gx1400/KiCad_PowerSupply_RegulatorAndControl/Regulator.kicad_pcb

## KiCad design Regulator.kicad_pcb (2017-05-18)

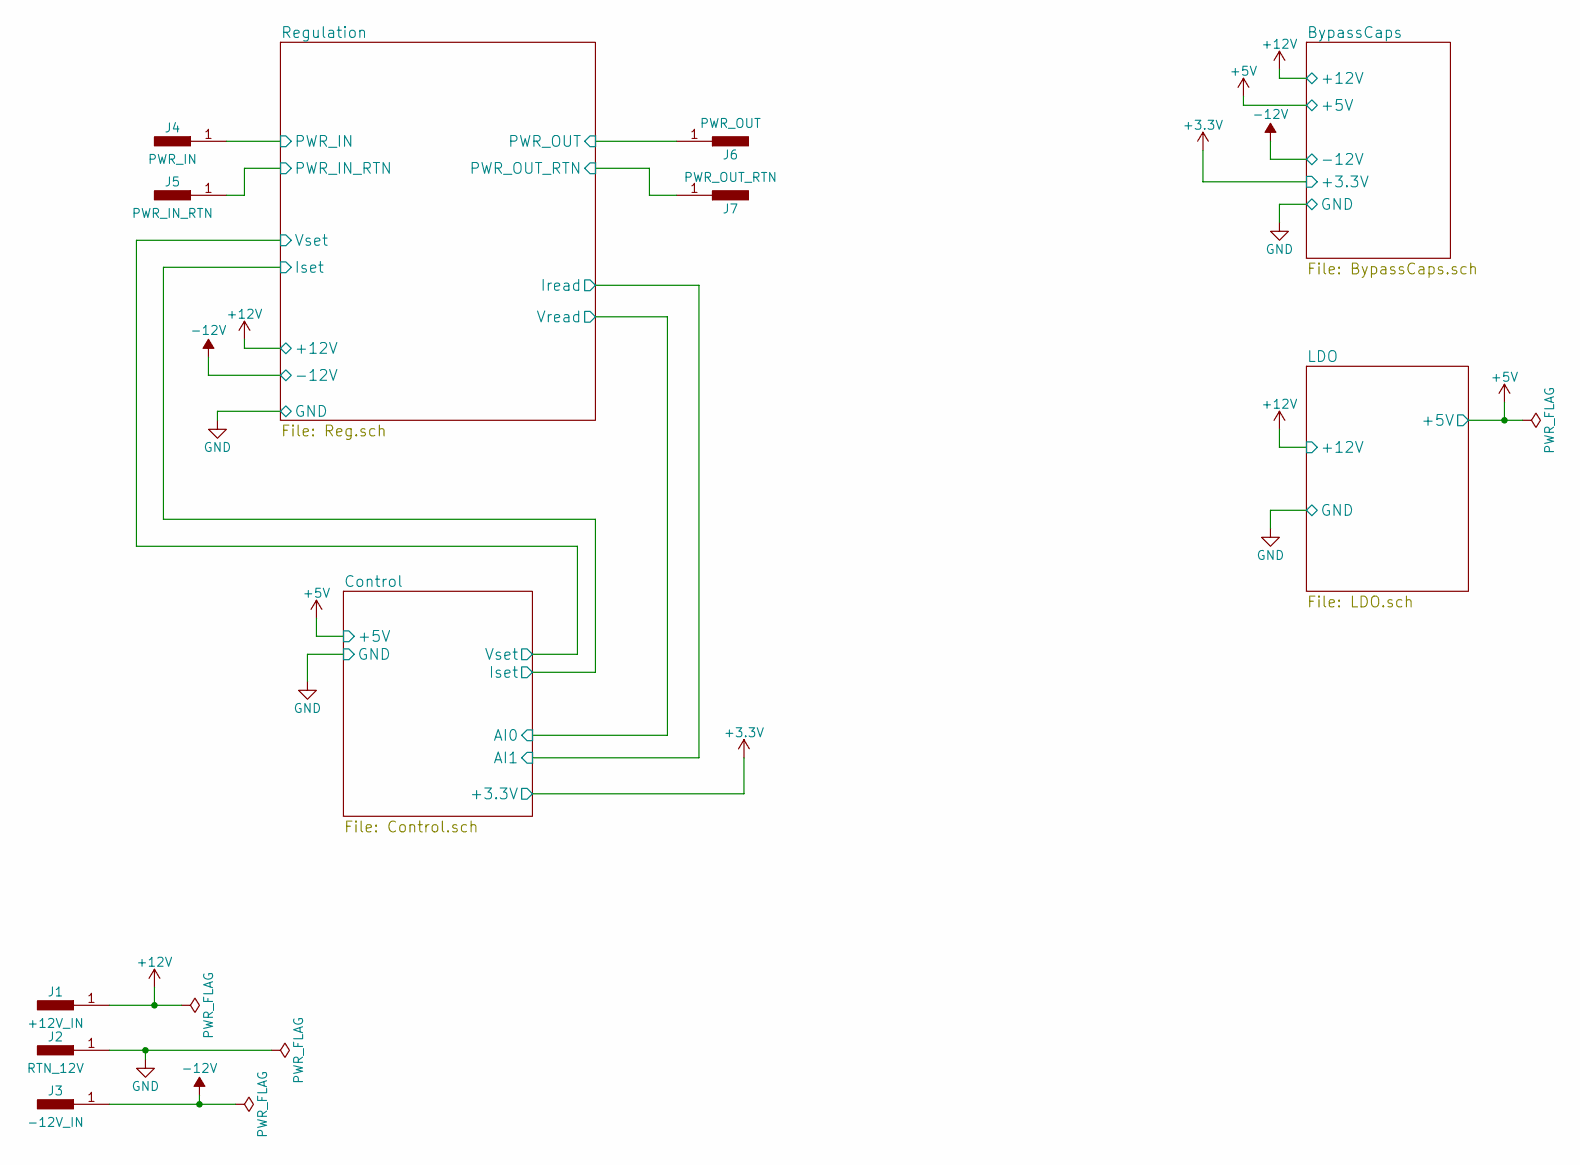
[picture p1: schematic Regulator.sch]

Parts:
J1: +12V_IN; SolderWirePad_2x_1-5mmDrill; MPN 1217861-1
J2: RTN_12V; SolderWirePad_2x_1-5mmDrill; MPN 1217861-1
J3: -12V_IN; SolderWirePad_2x_1-5mmDrill; MPN 1217861-1
J4: PWR_IN; SolderWirePad_2x_1-5mmDrill; MPN 1217861-1
J5: PWR_IN_RTN; SolderWirePad_2x_1-5mmDrill; MPN 1217861-1
J6: PWR_OUT; SolderWirePad_2x_1-5mmDrill; MPN 1217861-1
J7: PWR_OUT_RTN; SolderWirePad_2x_1-5mmDrill; MPN 1217861-1

Connections:
+12V: J1.1; also elsewhere on the board
-12V: J3.1; also elsewhere on the board
/Regulation/PWR_IN: J4.1; also elsewhere on the board
/Regulation/PWR_OUT: J6.1; also elsewhere on the board
GND: J2.1, J5.1, J7.1; also elsewhere on the board

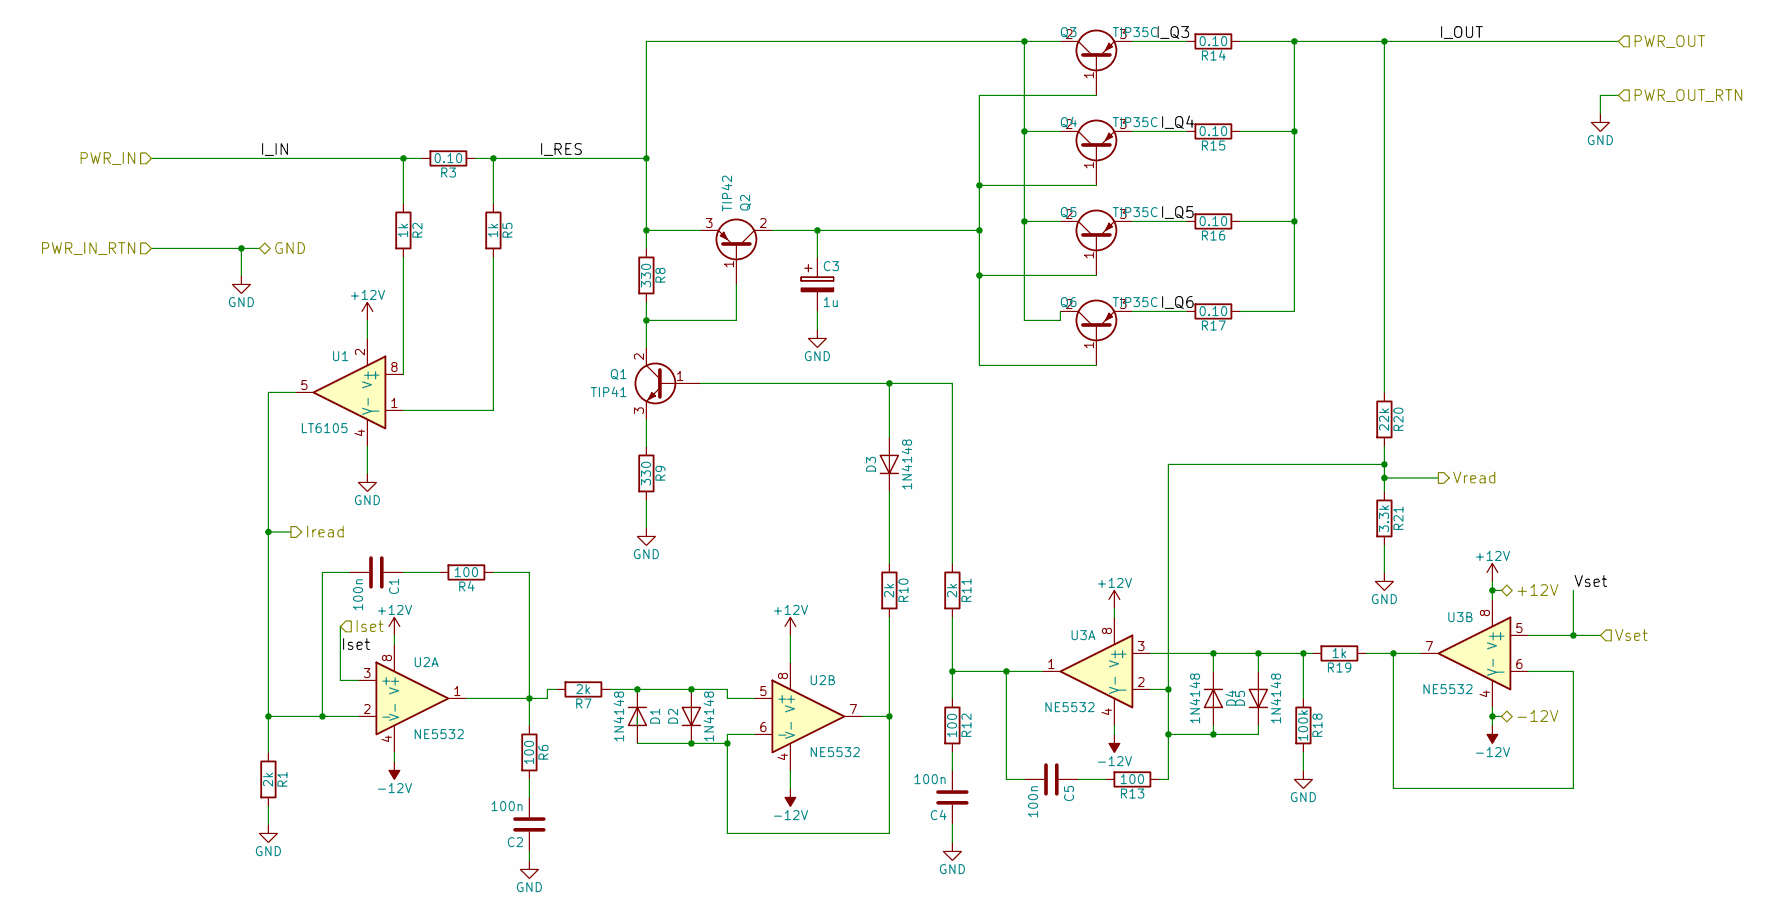
[picture p2: schematic Reg.sch]

Parts:
C1, C2, C4, C5: 100n; C_0805_HandSoldering; MPN CL21B104JBCNNNC
C3: 1u; CP_Radial_D4.0mm_P1.50mm; MPN CL21B105KBFNNNG
D1, D2, D3, D4, D5: 1N4148; D_SOD-123; MPN 1N4148W-TP
Q1: TIP41; TO-220_Vertical; MPN TIP41C
Q2: TIP42; TO-220_Vertical; MPN TIP42CTU
Q3, Q4, Q5, Q6: TIP35C; TO-247_TO-3P_Vertical; MPN TIP35CW
R1, R7, R10, R11: 2k; R_0805_HandSoldering; MPN ERJ-6ENF2001V
R2, R5, R19: 1k; R_0805_HandSoldering; MPN ERJ-6GEYJ102V
R3: 0.10; RESISTOR_SMD_BOURNES_DPAK; MPN PWR163S-25-R100F
R4, R6, R12, R13: 100; R_0805_HandSoldering; MPN ERJ-P06J101V
R8, R9: 330; R_0805_HandSoldering; MPN ERJ-6GEYJ331V
R14, R15, R16, R17: 0.10; R_2512_HandSoldering; MPN PE2512FKE070R1L
R18: 100k; R_0805_HandSoldering; MPN ERJ-6ENF1003V
R20: 22k; R_0805_HandSoldering; MPN ERJ-6ENF2202V
R21: 3.3k; R_0805_HandSoldering; MPN ERJ-6ENF3301V
U1: LT6105; MSOP-8_3x3mm_Pitch0.65mm; MPN LT6105CMS8#PBF
U2, U3: NE5532; SOIC-8_3.9x4.9mm_Pitch1.27mm; MPN NE5532DR

Connections:
+12V: U1.2 (V+), U2.8 (V+), U3.8 (V+); also elsewhere on the board
-12V: U2.4 (V-), U3.4 (V-); also elsewhere on the board
/Control/AI0: D4.2 (A), D5.1 (K), R13.1, R20.2, R21.1, U3.2 (-); also elsewhere on the board
/Control/AI1: C1.2, R1.1, U1.5, U2.2 (-); also elsewhere on the board
/Control/Iset: U2.3 (+); also elsewhere on the board
/Control/Vset: U3.5 (+); also elsewhere on the board
/Regulation/I_Q3: Q3.3 (E), R14.2
/Regulation/I_Q4: Q4.3 (E), R15.2
/Regulation/I_Q5: Q5.3 (E), R16.2
/Regulation/I_Q6: Q6.3 (E), R17.2
/Regulation/I_RES: Q2.3 (E), Q3.2 (C), Q4.2 (C), Q5.2 (C), Q6.2 (C), R3.1, R5.1, R8.1
/Regulation/PWR_IN: R2.1, R3.2; also elsewhere on the board
/Regulation/PWR_OUT: R14.1, R15.1, R16.1, R17.1, R20.1; also elsewhere on the board
GND: C2.1, C3.2, C4.1, R1.2, R9.2, R18.2, R21.2, U1.4 (V-); also elsewhere on the board
unnamed: C1.1, R4.2
unnamed: C2.2, R6.2
unnamed: C3.1, Q2.2 (C), Q3.1 (B), Q4.1 (B), Q5.1 (B), Q6.1 (B)
unnamed: C4.2, R12.2
unnamed: C5.1, R13.2
unnamed: C5.2, R11.2, R12.1, U3.1
unnamed: D1.1 (K), D2.2 (A), R7.1, U2.5 (+)
unnamed: D1.2 (A), D2.1 (K), R10.2, U2.6 (-), U2.7
unnamed: D3.1 (K), R10.1
unnamed: D3.2 (A), Q1.1 (B), R11.1
unnamed: D4.1 (K), D5.2 (A), R18.1, R19.2, U3.3 (+)
unnamed: Q1.2 (C), Q2.1 (B), R8.2
unnamed: Q1.3 (E), R9.1
unnamed: R2.2, U1.8 (+)
unnamed: R4.1, R6.1, R7.2, U2.1
unnamed: R5.2, U1.1 (-)
unnamed: R19.1, U3.6 (-), U3.7

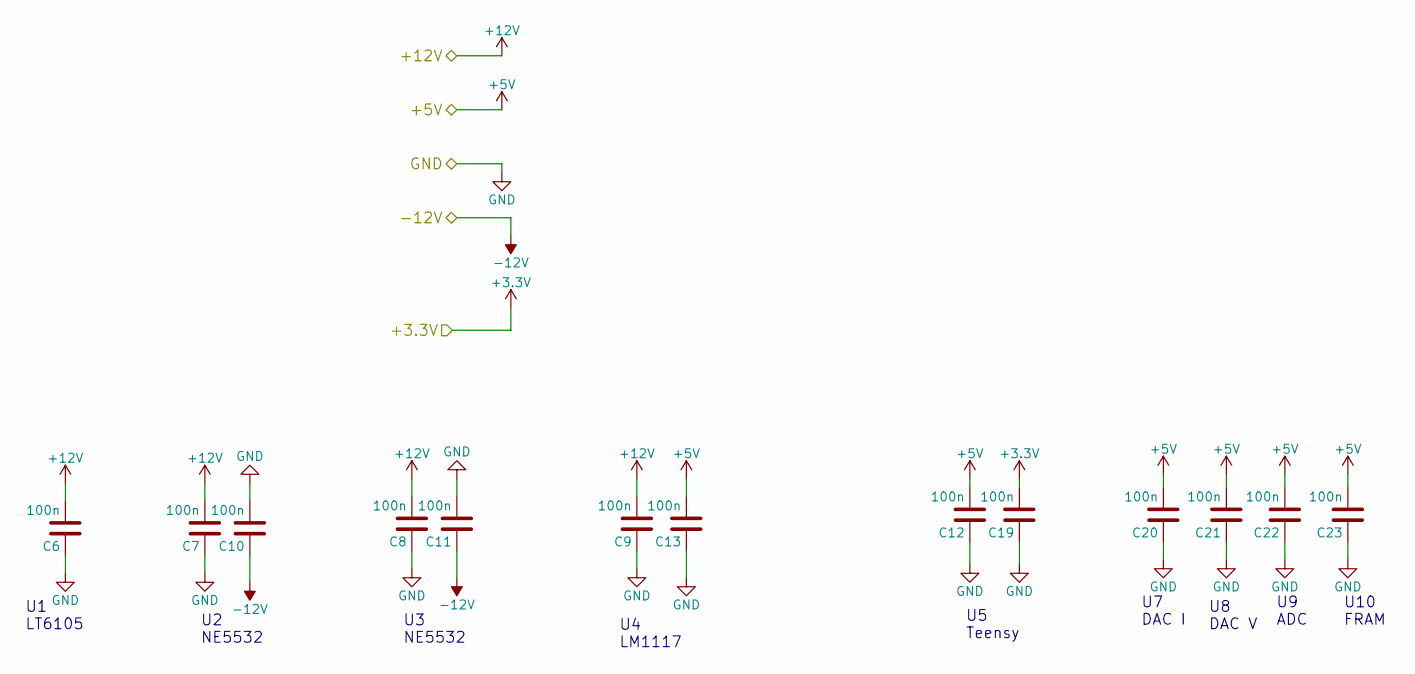
[picture p3: schematic BypassCaps.sch]

Parts:
C6, C7, C8, C9, C10, C11, C12, C13, C19, C20, C21, C22, C23: 100n; C_0805_HandSoldering; MPN CL21B104JBCNNNC

Connections:
+3V3: C19.2; also elsewhere on the board
+5V: C12.2, C13.2, C20.2, C21.2, C22.2, C23.2; also elsewhere on the board
+12V: C6.2, C7.2, C8.2, C9.2; also elsewhere on the board
-12V: C10.1, C11.1; also elsewhere on the board
GND: C6.1, C7.1, C8.1, C9.1, C10.2, C11.2, C12.1, C13.1, C19.1, C20.1, C21.1, C22.1, C23.1; also elsewhere on the board

Notes on the sheet:
U1 LT6105
U2 NE5532
U3 NE5532
U4 LM1117
U5 Teensy
U7 DAC I
U8 DAC V
U9 ADC
U10 FRAM

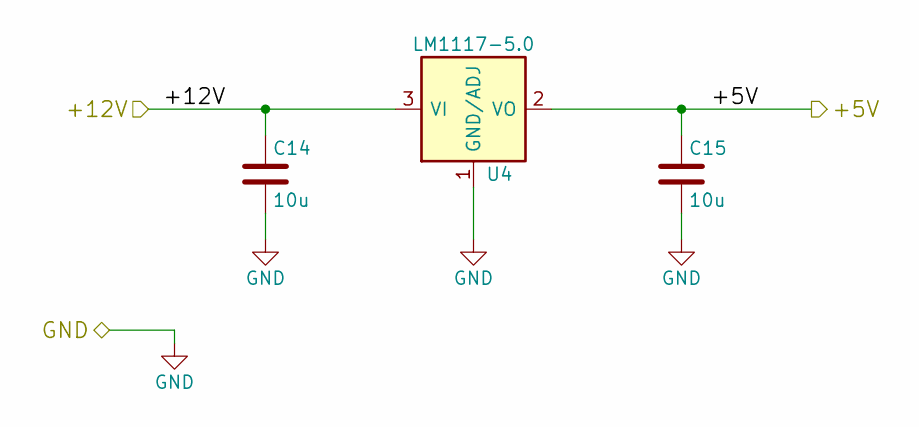
[picture p4: schematic LDO.sch]

Parts:
C14, C15: 10u; C_0805_HandSoldering; MPN F951C106MPAAQ2
U4: LM1117-5.0; SOT-223; MPN LM1117MP-5.0/NOPB

Connections:
+5V: C15.1, U4.2 (VO), U4.4 (VO); also elsewhere on the board
+12V: C14.1, U4.3 (VI); also elsewhere on the board
GND: C14.2, C15.2, U4.1 (GND/ADJ); also elsewhere on the board

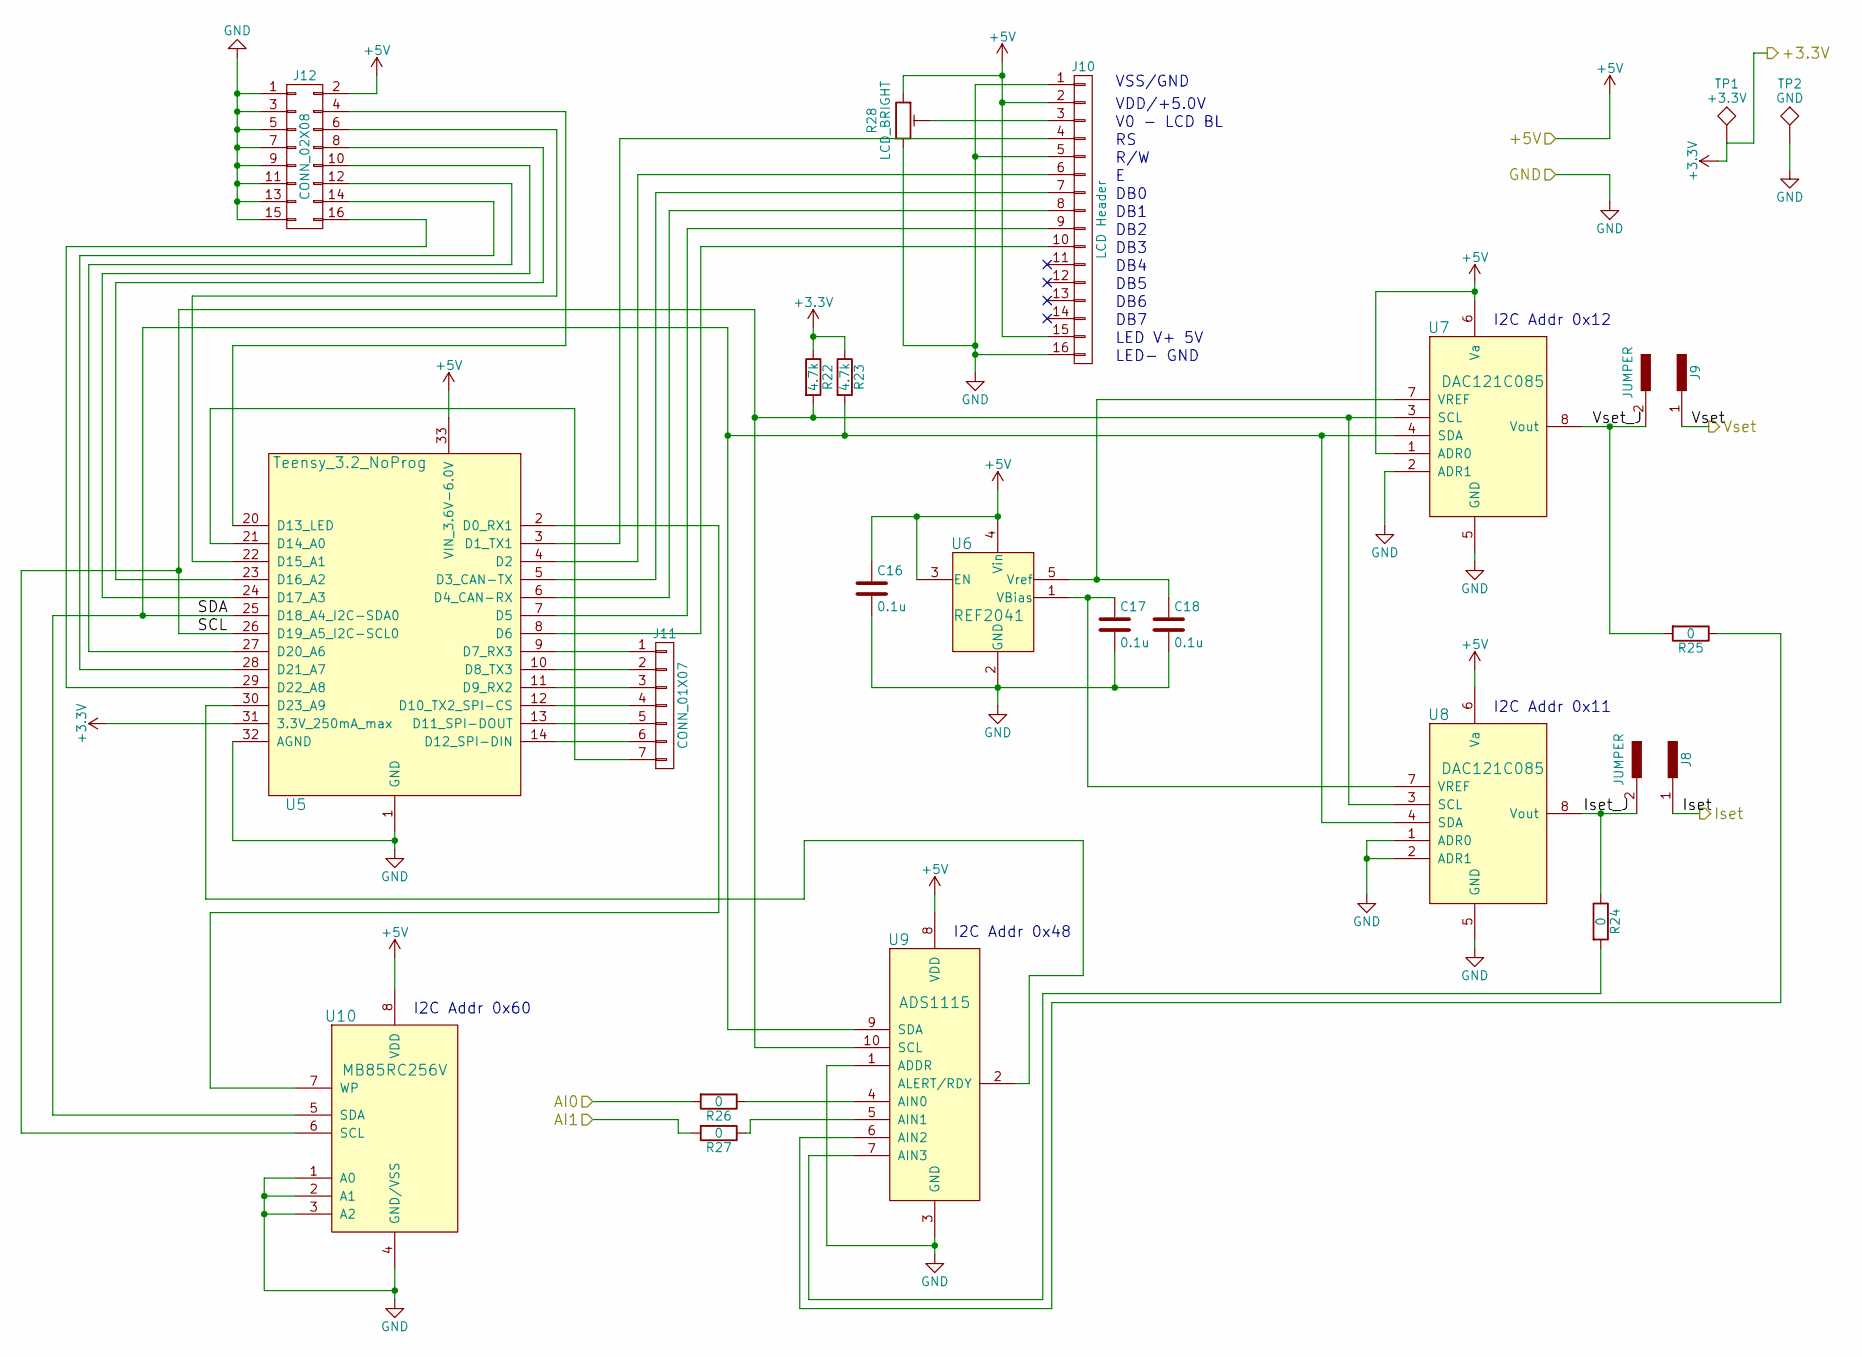
[picture p5: schematic Control.sch]

Parts:
C16, C17, C18: 0.1u; C_0805_HandSoldering; MPN C0805C104K4RACTU
J8, J9: JUMPER; R_0805_HandSoldering
J10: LCD Header; Pin_Header_Straight_1x16_Pitch2.54mm
J11: CONN_01X07; Pin_Header_Straight_1x07_Pitch2.54mm
J12: CONN_02X08; IDC_Header_Straight_16pins
R22, R23: 4.7k; R_0805_HandSoldering; MPN ERJ-6GEYJ472V
R24, R25, R26, R27: 0; R_0805_HandSoldering; MPN ERJ-6GEY0R00V
R28: LCD_BRIGHT; Potentiometer_Trimmer_Bourns_3266Y; MPN 3266Y-1-503LF
TP1: +3.3V; Test_Point_Keystone_5000-5004_Miniature; MPN 5000
TP2: GND; Test_Point_Keystone_5000-5004_Miniature; MPN 5001
U5: Teensy_3.2_NoProg; CUSTOM_Teensy_3.2_NoProg; MPN Teensy3.2
U6: REF2041; SOT-23-5_HandSoldering
U7, U8: DAC121C085; MSOP-8_3x3mm_Pitch0.65mm; MPN DAC121C085CIMM/NOPB
U9: ADS1115; MSOP-10_3x3mm_Pitch0.5mm; MPN ADS1115IDGST
U10: MB85RC256V; SOIJ-8_5.3x5.3mm_Pitch1.27mm; MPN MB85RC256VPF-G-JNERE2

Connections:
+3V3: R22.1, R23.1, TP1.1, U5.31 (3.3V_250mA_max); also elsewhere on the board
+5V: C16.1, J10.2, J10.15, J12.2, R28.1, U5.33 (VIN_3.6V-6.0V), U6.3 (EN), U6.4 (Vin), U7.1 (ADR0), U7.6 (Va), U8.6 (Va), U9.8 (VDD), U10.8 (VDD); also elsewhere on the board
/Control/AI0: R26.2; also elsewhere on the board
/Control/AI1: R27.2; also elsewhere on the board
/Control/Iset: J8.1; also elsewhere on the board
/Control/Iset_J: J8.2, R24.1, U8.8 (Vout)
/Control/SCL: R22.2, U5.26 (D19_A5_I2C-SCL0), U7.3 (SCL), U8.3 (SCL), U9.10 (SCL), U10.6 (SCL)
/Control/SDA: R23.2, U5.25 (D18_A4_I2C-SDA0), U7.4 (SDA), U8.4 (SDA), U9.9 (SDA), U10.5 (SDA)
/Control/Vset: J9.1; also elsewhere on the board
/Control/Vset_J: J9.2, R25.2, U7.8 (Vout)
GND: C16.2, C17.2, C18.2, J10.1, J10.5, J10.16, J12.1, J12.3, J12.5, J12.7, J12.9, J12.11, J12.13, J12.15, R28.3, TP2.1, U5.1 (GND), U5.32 (AGND), U6.2 (GND), U7.2 (ADR1), U7.5 (GND), U8.1 (ADR0), U8.2 (ADR1), U8.5 (GND), U9.1 (ADDR), U9.3 (GND), U10.1 (A0), U10.2 (A1), U10.3 (A2), U10.4 (GND/VSS); also elsewhere on the board
unnamed: C17.1, U6.1 (VBias), U8.7 (VREF)
unnamed: C18.1, U6.5 (Vref), U7.7 (VREF)
unnamed: J10.3, R28.2
unnamed: J10.4, U5.3 (D1_TX1)
unnamed: J10.6, U5.4 (D2)
unnamed: J10.7, U5.5 (D3_CAN-TX)
unnamed: J10.8, U5.6 (D4_CAN-RX)
unnamed: J10.9, U5.7 (D5)
unnamed: J10.10, U5.8 (D6)
unnamed: J11.1, U5.9 (D7_RX3)
unnamed: J11.2, U5.10 (D8_TX3)
unnamed: J11.3, U5.11 (D9_RX2)
unnamed: J11.4, U5.12 (D10_TX2_SPI-CS)
unnamed: J11.5, U5.13 (D11_SPI-DOUT)
unnamed: J11.6, U5.14 (D12_SPI-DIN)
unnamed: J11.7, U5.21 (D14_A0)
unnamed: J12.4, U5.20 (D13_LED)
unnamed: J12.6, U5.22 (D15_A1)
unnamed: J12.8, U5.23 (D16_A2)
unnamed: J12.10, U5.24 (D17_A3)
unnamed: J12.12, U5.27 (D20_A6)
unnamed: J12.14, U5.28 (D21_A7)
unnamed: J12.16, U5.29 (D22_A8)
unnamed: R24.2, U9.7 (AIN3)
unnamed: R25.1, U9.6 (AIN2)
unnamed: R26.1, U9.4 (AIN0)
unnamed: R27.1, U9.5 (AIN1)
unnamed: U5.30 (D23_A9), U9.2 (ALERT/RDY)
unnamed: U5.2 (D0_RX1), U10.7 (WP)

Notes on the sheet:
I2C Addr 0x12
I2C Addr 0x11
I2C Addr 0x48
I2C Addr 0x60
VSS/GND
VDD/+5.0V
V0 - LCD BL
R/W
DB0
DB1
DB2
DB3
DB4
DB5
DB6
DB7
LED V+ 5V
LED- GND

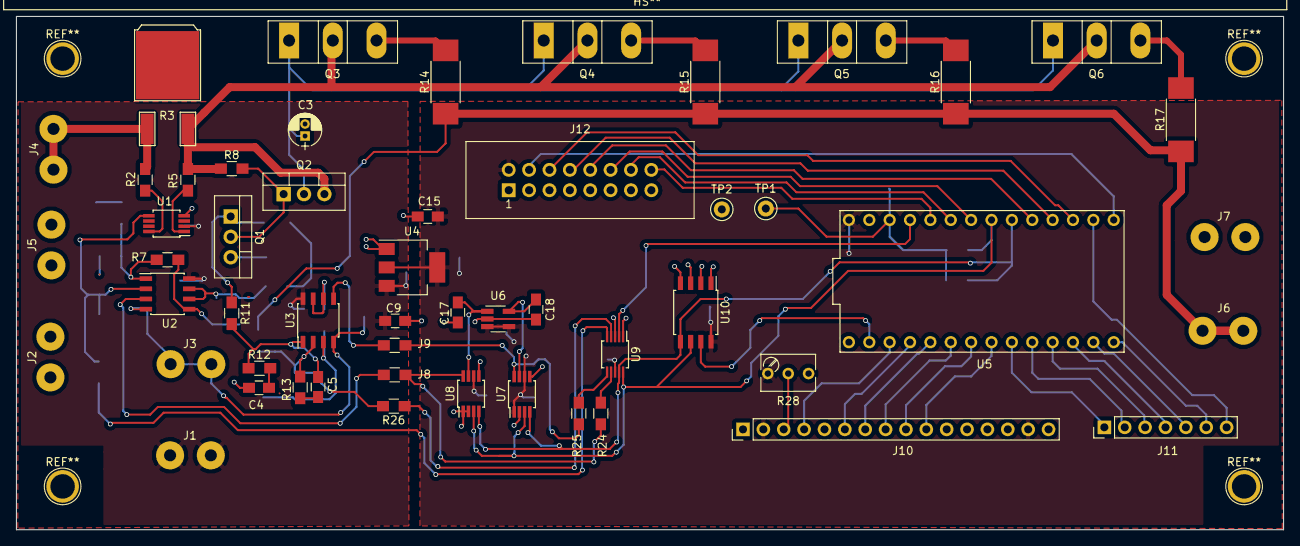
[picture p6: board Regulator.kicad_pcb from above]

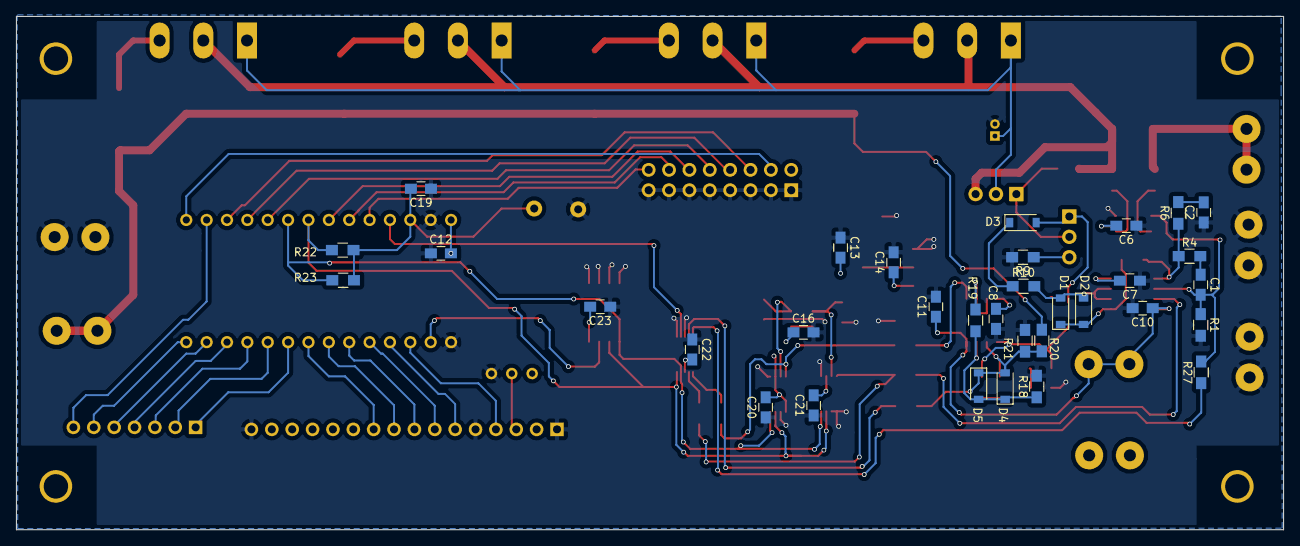
[picture p7: board Regulator.kicad_pcb from below]

Board: 2 copper layers, 158.0 x 64.0 mm, 87 parts (33 on the bottom side), 66 nets.

Other parts of the board:
HS**: Heatsink_160x80x26.9mm
