gx1400/KiCad_PowerSupply_RegulatorAndControl/(commit log)

2017-05-17 Updates + Lot of routing
    [BypassCaps.sch, Control.sch, LDO.sch, Reg.sch, Regulator.kicad_pcb]
2017-05-18 Finished routing
    [BypassCaps.sch, Control.sch, Regulator.kicad_pcb]
